papa1300/train_arduino_projet/5-VICART.docx

Vicart Paul G4

Compte-rendu Projet Arduino

5è^me séance :

J’ai commencé par résoudre le problème de la séance d’avant, qui était donc un problème de driver non installé sur mon ordinateur (ce que je ne comprends pas vraiment car cela marchait correctement les séances d’avant). J’ai donc ensuite réalisé le montage et l’ai connecté au générateur pour tester le programme test et ainsi vérifier si le montage fonctionnait bien et surtout voir la consommation totale. Nous sommes donc sur une consommation d’environ 400 mA/h. On m’a donc fourni une batterie largement suffisante pour la tâche (aux alentours de 1200 mA/h).

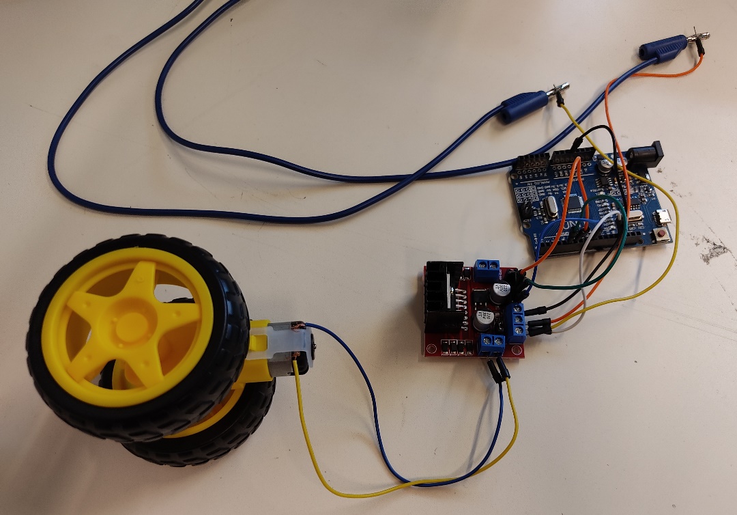
[picture p31: figure]

J’ai ensuite réalisé un prototype en carton de la structure du train puis j’ai réalisé leur modèle final sur onshape pour la découpeuse laser (qui sera effectué la séance prochaine). Voici les maquettes ainsi qu’un exemple d’une pièce:

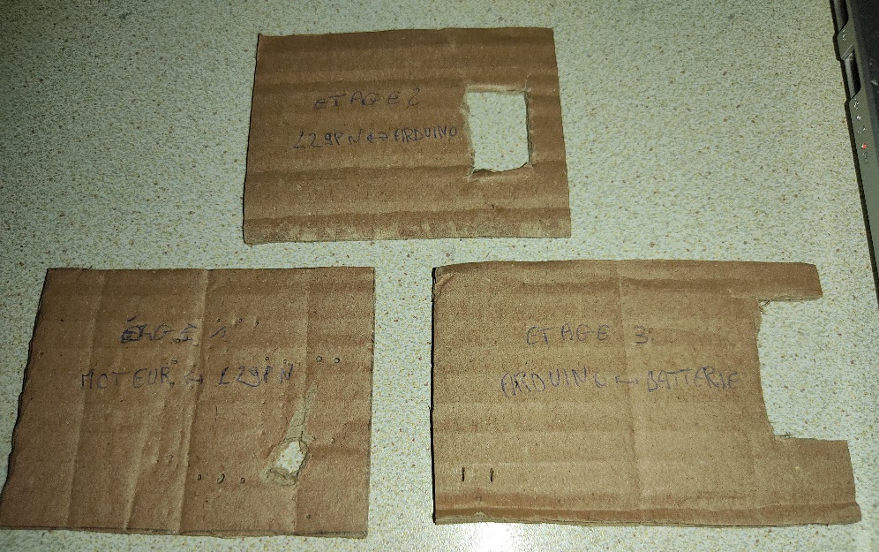
[picture p32: figure]
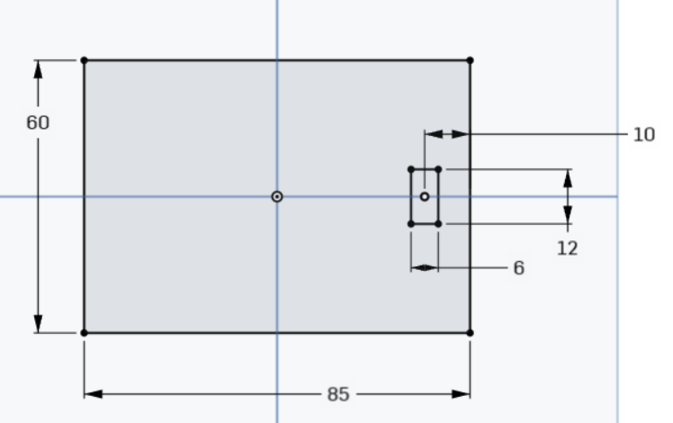
[picture p33: figure]
