papa1300/train_arduino_projet/Partie-Pince-pdf.pdf

# Partie pince

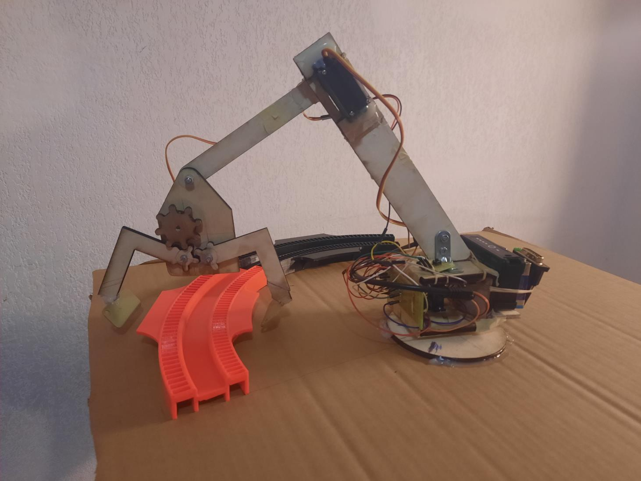
[picture p69: figure]

- Les mouvements que le bras doit réaliser : -tourner à 360°
-monter/descendre la pince -fermer/ouvrir la pince

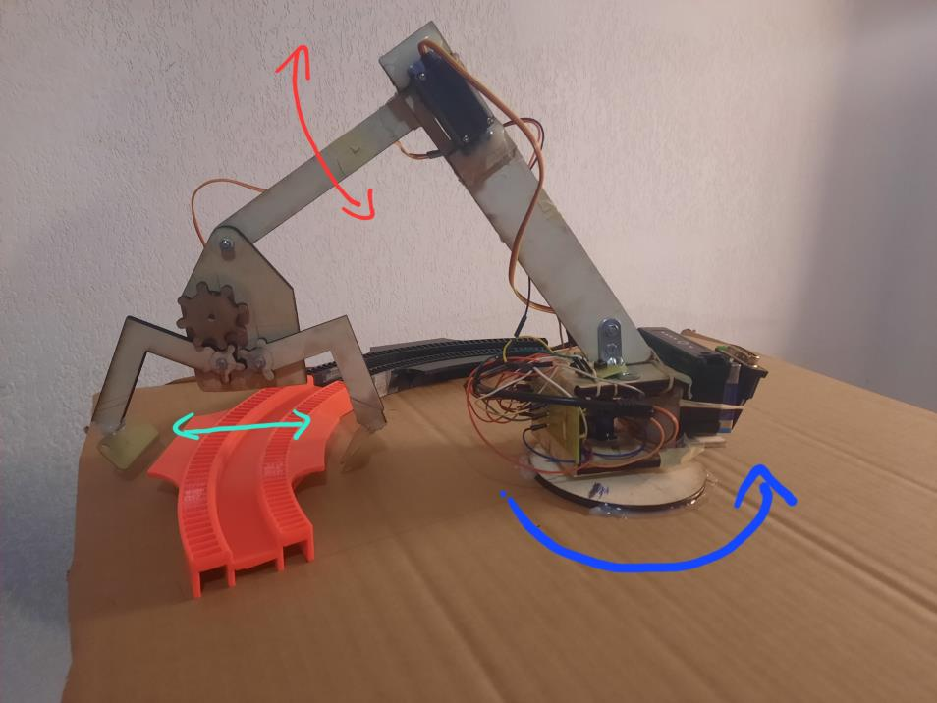
[picture p70: figure]

Réalisation d’une maquette en carton pour répondre à ces attentes avant de réaliser le bras en bois

## La maquette

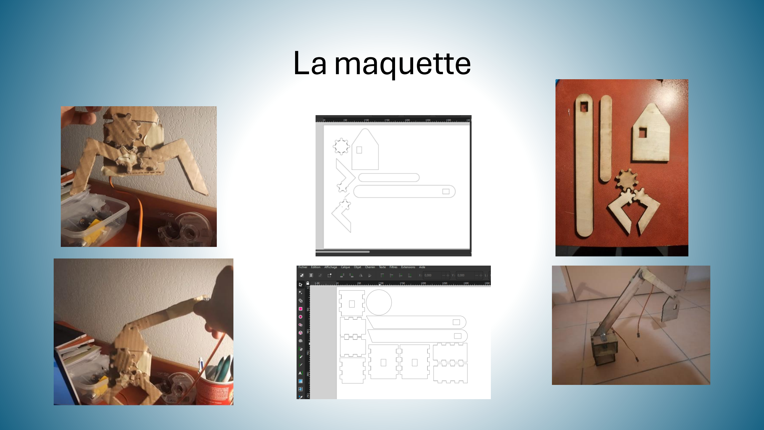
[picture p71: page 3]

## Rotation a 360°

- Utilisation d’un moteur continu

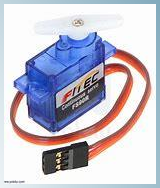
[picture p72: figure]

- Contraintes:- l’ensemble des composant du bras doivent être en rotation
-le bras doit être en équilibre sur le socle

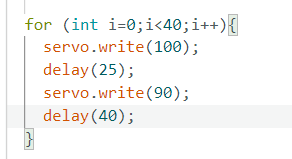
[picture p73: figure]

- Pour varier la vitesse:

## Monter/Descendre la pince

- Utilisation d’un servomoteur (180°)
- Contrainte : le moteur ne peut plus se lever à partir d’un certain poids

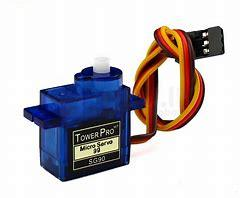
[picture p74: figure]
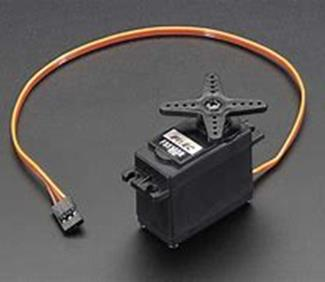
[picture p75: figure]

## Fermer/Ouvrir la pince

- Utilisation d’un servomoteur (180°)
- Mécanisme avec des disques dentés:

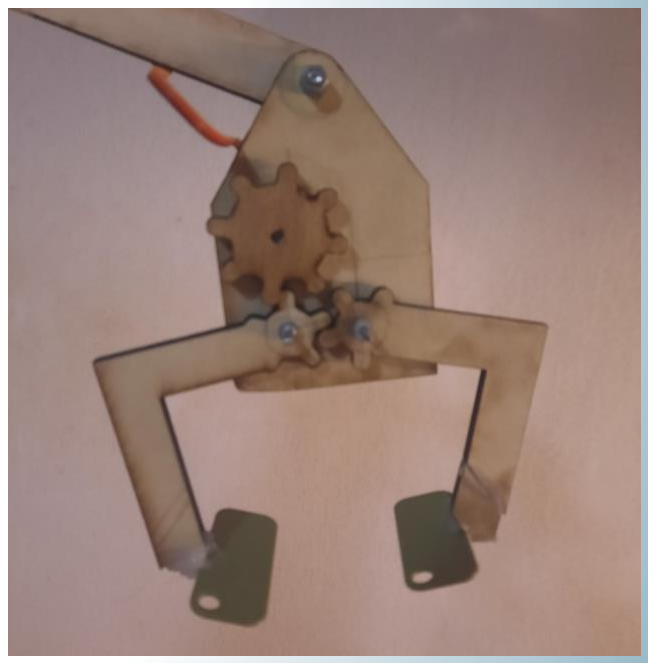
[picture p76: figure]

- La pince est équipée de plateforme capablede porter le rail
