papa1300/train_arduino_projet/4-VICART.docx

Vicart Paul G4

Compte-rendu Projet Arduino

4è^me séance :

Je voulais ici faire d’abord un modèle simplifié de la voiture pour ainsi tester si le modèle des 2 roues sur le même moteur fonctionnait, et mesurer également les valeurs de puissances pour choisir l’alimentation correspondant au besoin du véhicule. J’ai donc réaliser le montage ci-contre :

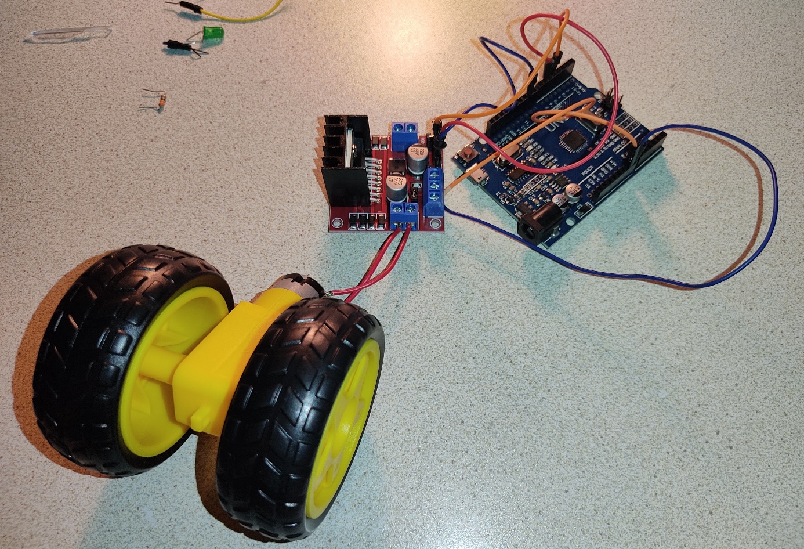
[picture p81: figure]

Et j’ai également voulu testé le code ci contre :

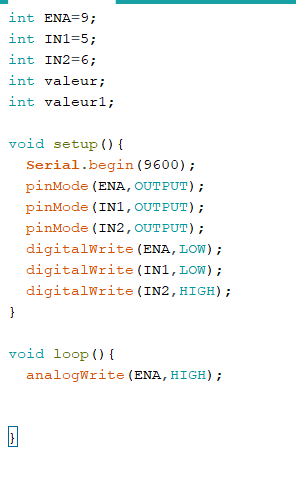
[picture p82: figure]

Je me suis néanmoins heurté à une erreur lors de l’exécution du programme que je n’ai pas réussi à résoudre lors de la séance. De plus, je ne peux pas reproduire actuellement le problème car je n’ai pas de câble usb lors de l’écriture de ce rapport.
