papa1300/train_arduino_projet/plan-voiture.pdf

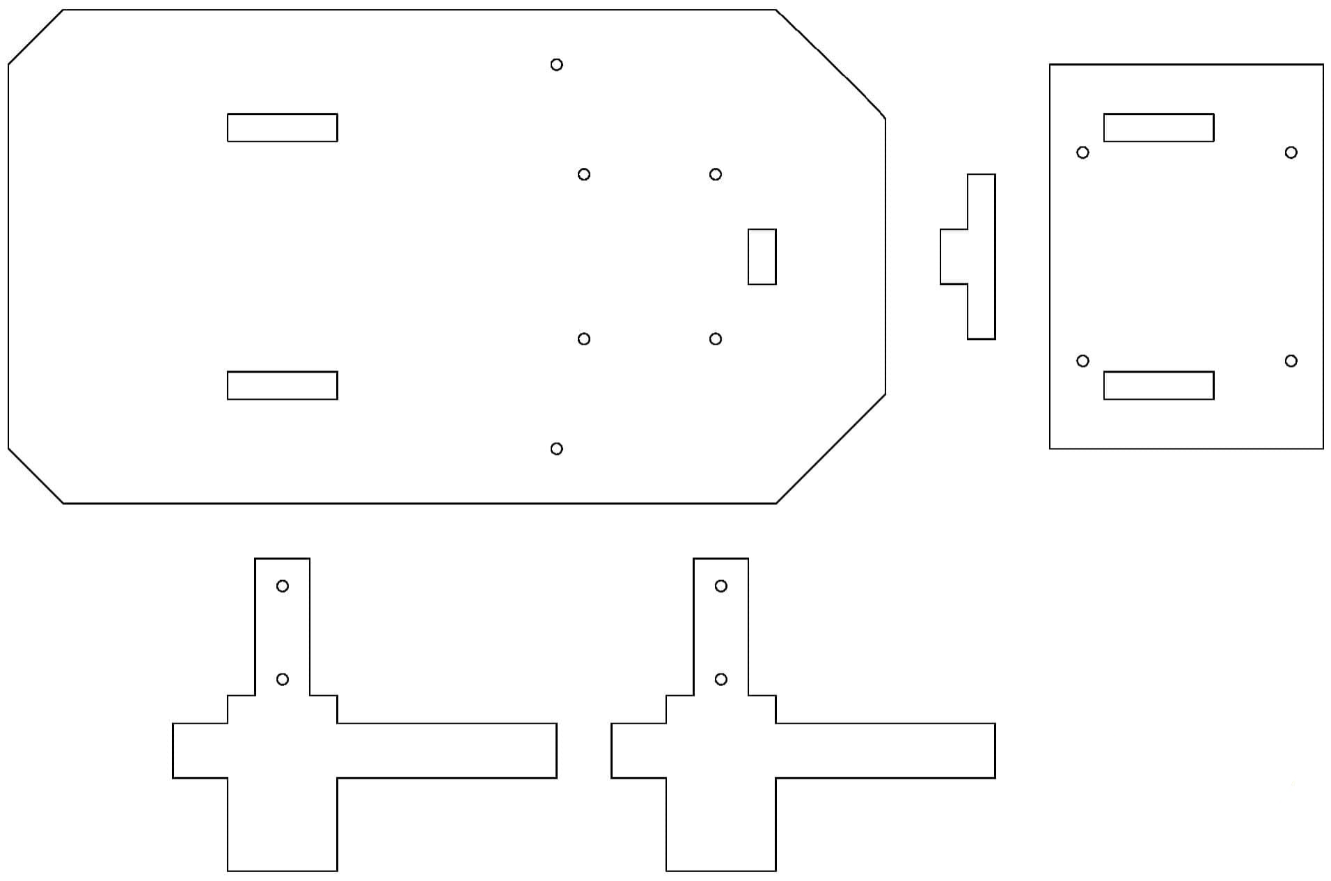
[picture p83: page 1]
