papa1300/train_arduino_projet/(commit log)

2024-01-11 Add files via upload
    Rapport de séance 3
2024-03-05 Add files via upload
    Vidéo de la pince
